Mr-Seoul/FPGA_Control_System/SystemAnalysis/TempReading.png

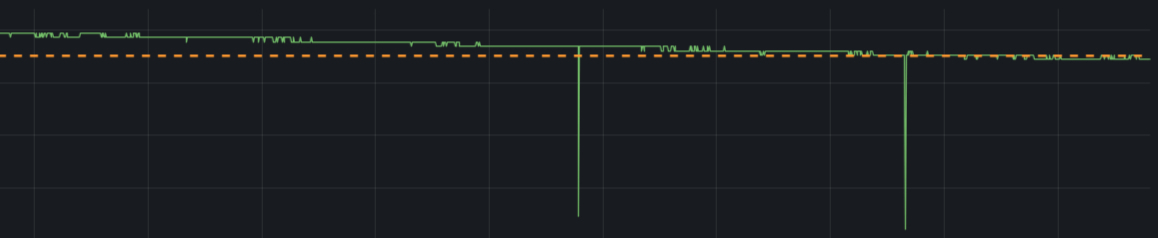
SystemAnalysis/TempReading.png
