Mr-Seoul/FPGA_Control_System/schematic.pdf

# FDCE Q C

# FDCE Q C

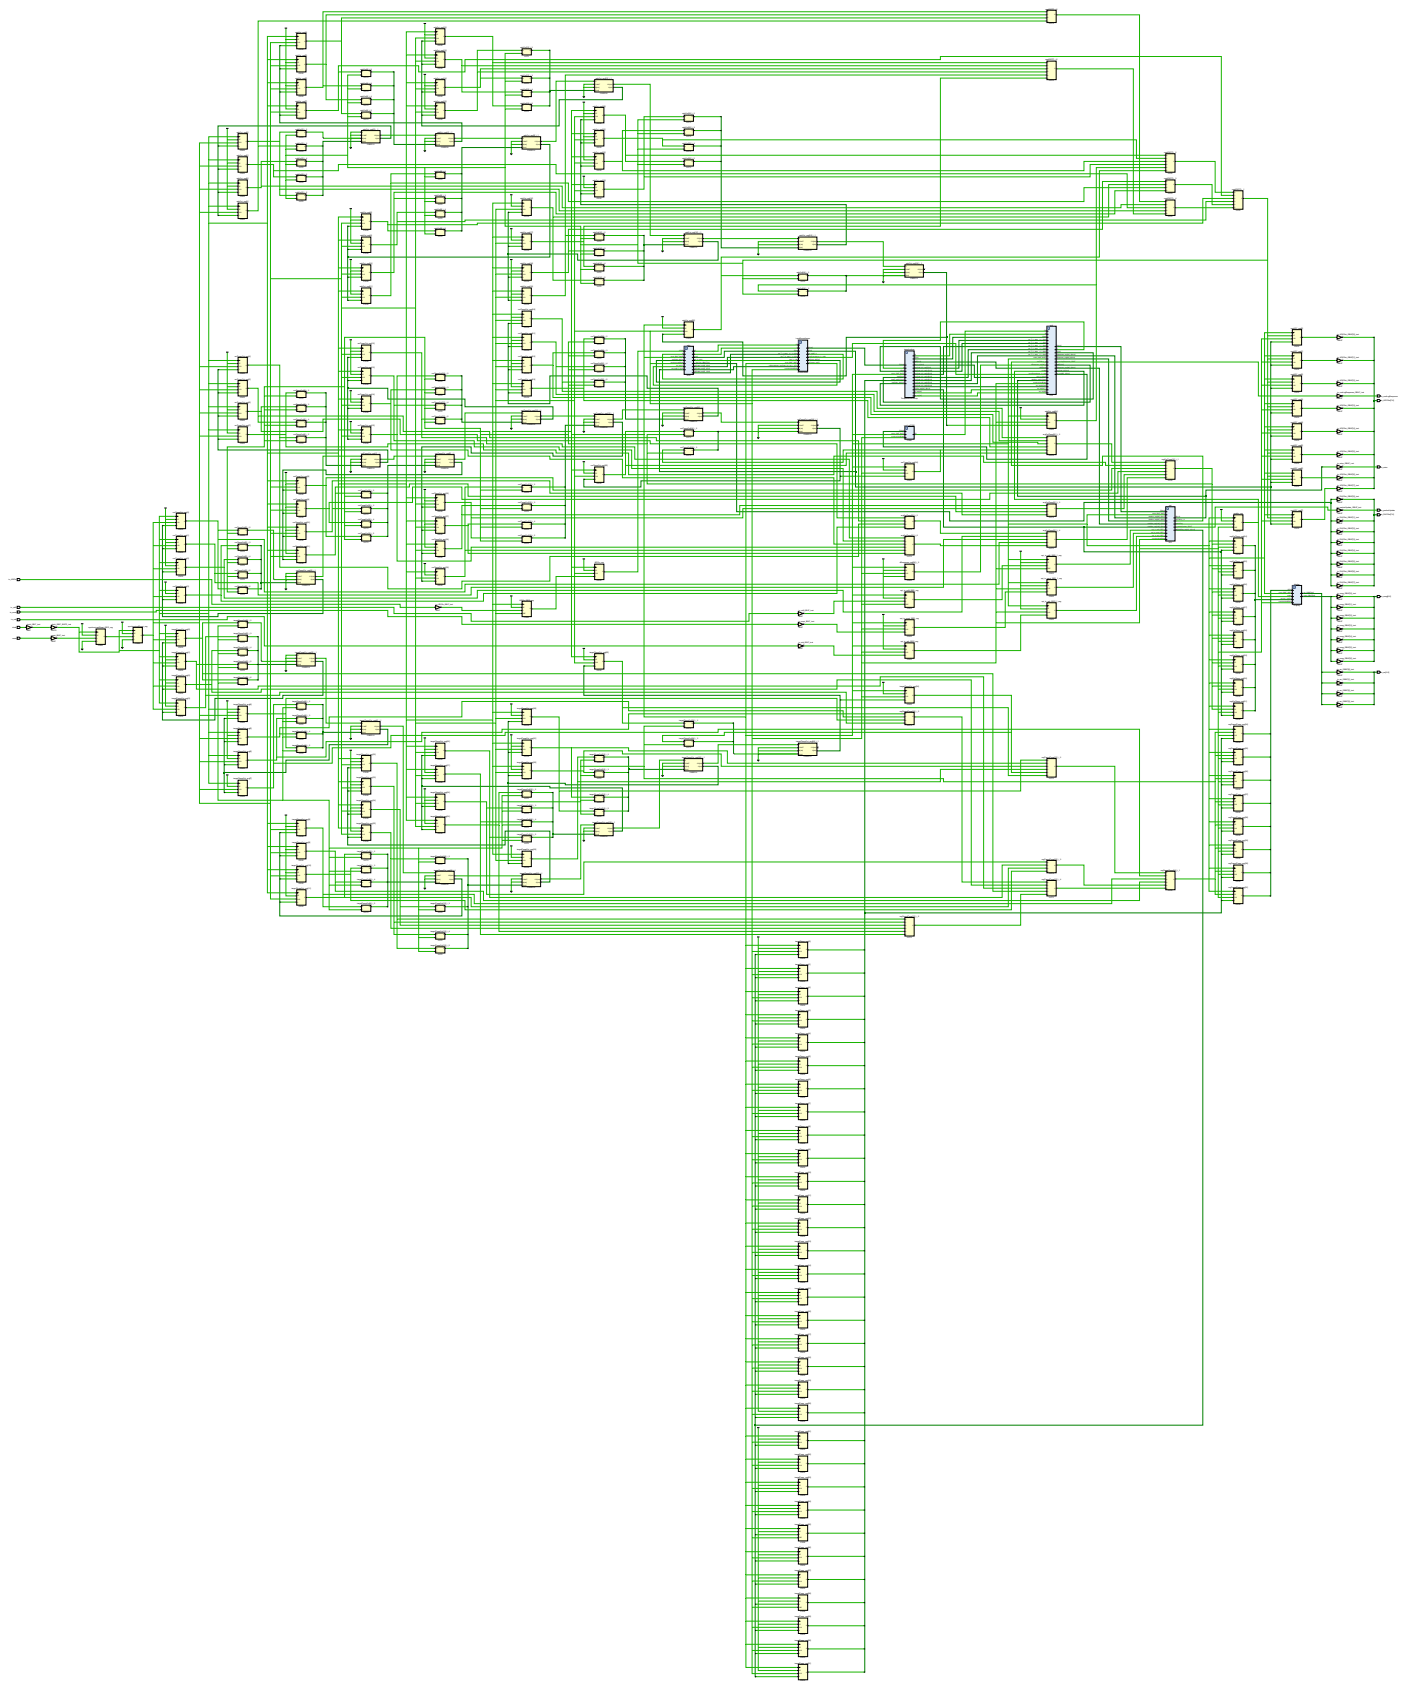
[picture p13: page 1]
io_ADCIn; io_csN; io_mosi; io_sck; clock; reset; clock_IBUF_inst; IBUF I; clock_IBUF_BUFG_inst BUFG I; reset_IBUF_inst; synchronizedReset_REG_reg FDRE Q C CEDR; synchronizedReset_reg FDRE Q C CEDR; curTempCnt_reg[0] FDCE Q C CECLR D; curTempCnt_reg[1] FDCE Q C CECLR D; curTempCnt_reg[2] FDCE Q C CECLR D; curTempCnt_reg[3] FDCE Q C CECLR D; targetTempCnt_reg[0] FDCE Q C CECLR D; targetTempCnt_reg[1] FDCE Q C CECLR D; targetTempCnt_reg[2] FDCE Q C CECLR D; targetTempCnt_reg[3] FDCE Q C CECLR D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

adcCnt[8]_i_2 I0 O I1 LUT2 | adcCnt_reg[23]

adcCnt[8]_i_3 I0 I1 adcCnt[8]_i_4 LUT2 O I0 O I1 LUT2 | adcCnt_reg[16] CECLR D

adcCnt[16]_i_2 I0 O I1 adcCnt[16]_i_3 LUT2

curTempCnt[4]_i_2 I0 O I1 curTempCnt[4]_i_3 LUT2 I0 I1 curTempCnt[4]_i_4 O LUT2 | CECLR D FDCE Q C

I0 I1 LUT2 O

adcCnt_reg[24] FDCE Q C CECLR D regCurTemp[31]_i_2 I0 I1 I2 I3 LUT6 O I4 I5

curTempCnt[0]_i_2 I0 O LUT2 | curTempCnt_reg[4]_i_1 CARRY4 CI CYINIT CO[3:0] DI[3:0] O[3:0] S[3:0] | I1 LUT2
