Mr-Seoul/FPGA_Control_System/(commit log)

2026-06-09 Built PID simulation tool
2026-06-10 Added measured heatTransferRate and implemented ADC
2026-06-10 Optimized tests and fixed sampling period bug in ADC
2026-06-13 Initial Documentation for ADC and System Design
2026-06-22 Added ADC data and combined system parts in chisel code
2026-06-25 Added communication with the ESP (SPI)
2026-07-05 Implemented SPI and graphs from testing
2026-07-05 Fixed PID clipping issues and commented hard to understand code for readabilty
    [PID.anno.json]
2026-07-18 Improved coverage of Accumulator and PID tests
2026-07-21 Fixed setup time violation
    [Controller.v]
2026-07-27 Moved PID values to config object
2026-07-27 Moved PWM constants to config object
